william-rosenberg/cubilox-mk1/hardware/electronics/cubilox_mk1_schematic.pdf

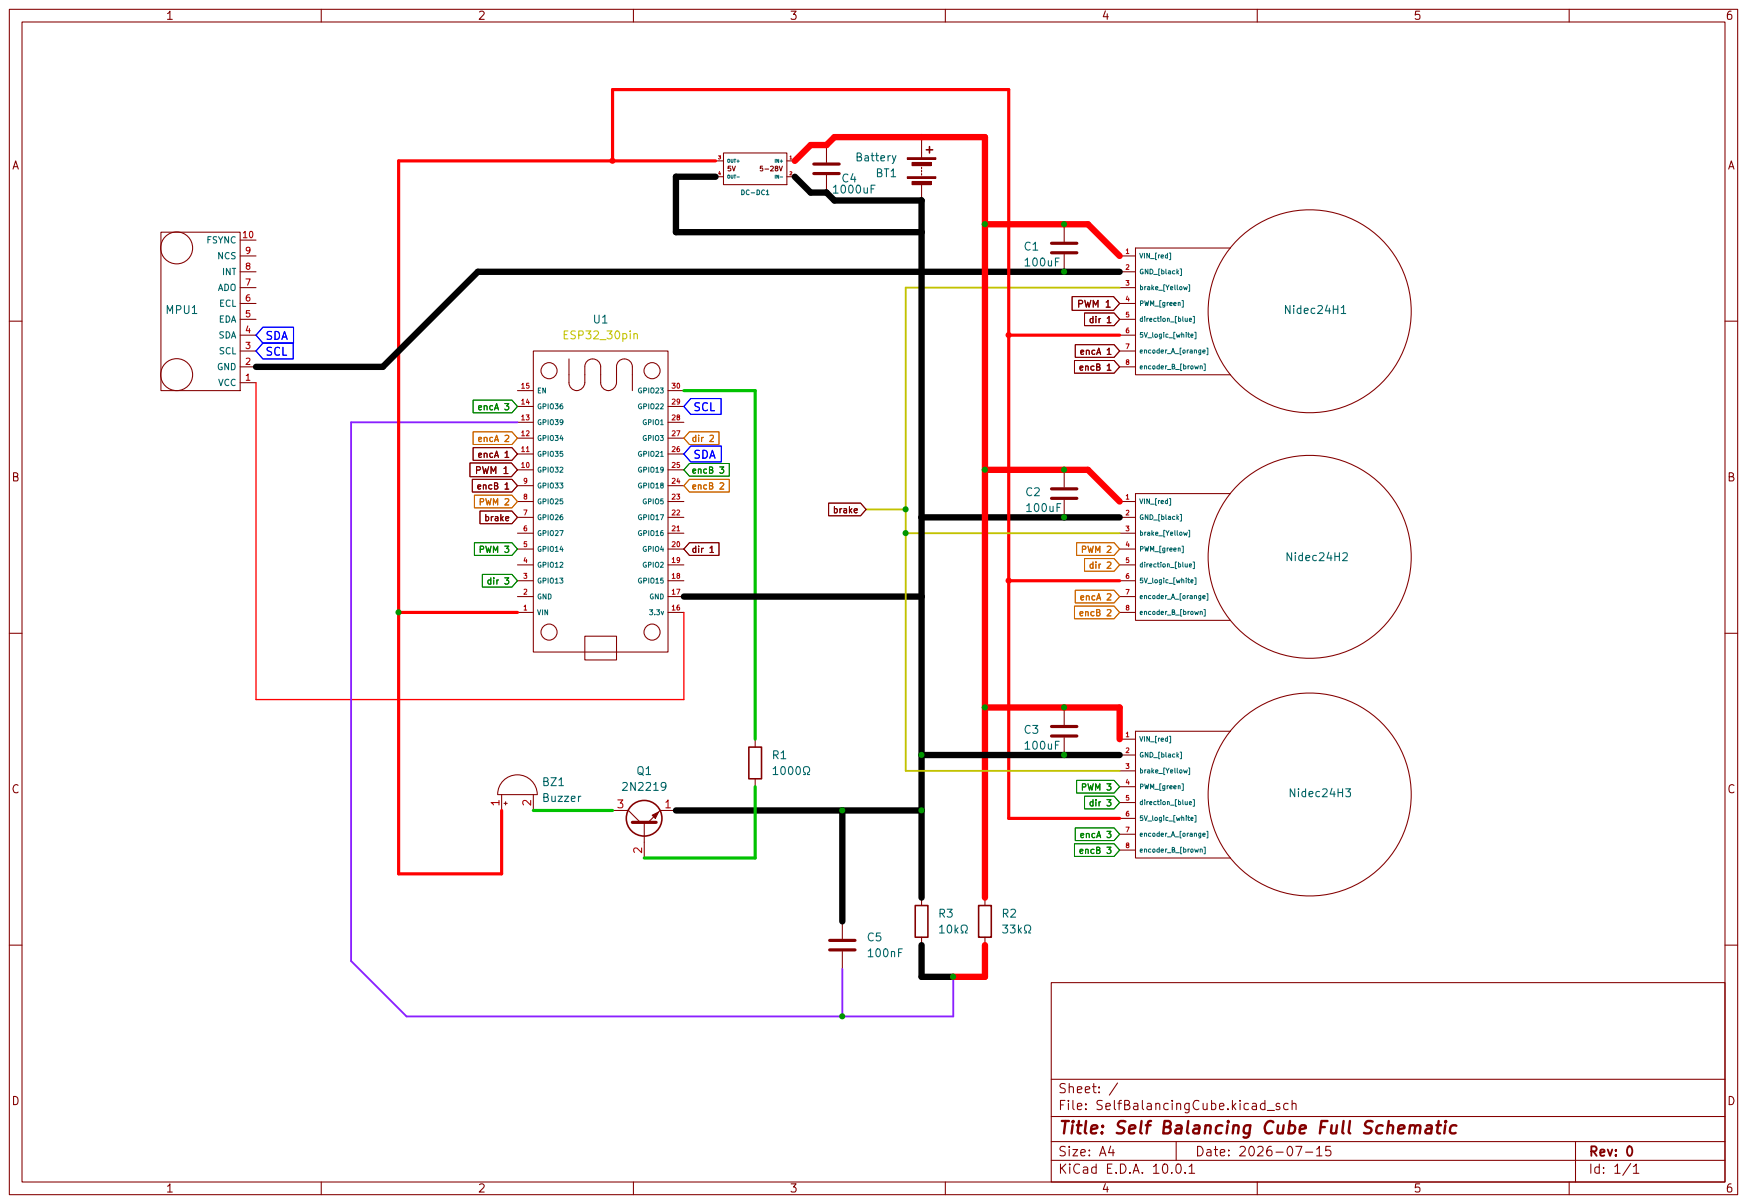
[picture p20: page 1]
